Mottramlabs/RGB-LED-Coaster-Using-a-PIC/PCB Layout/RGB Coaster With PIC.pdf

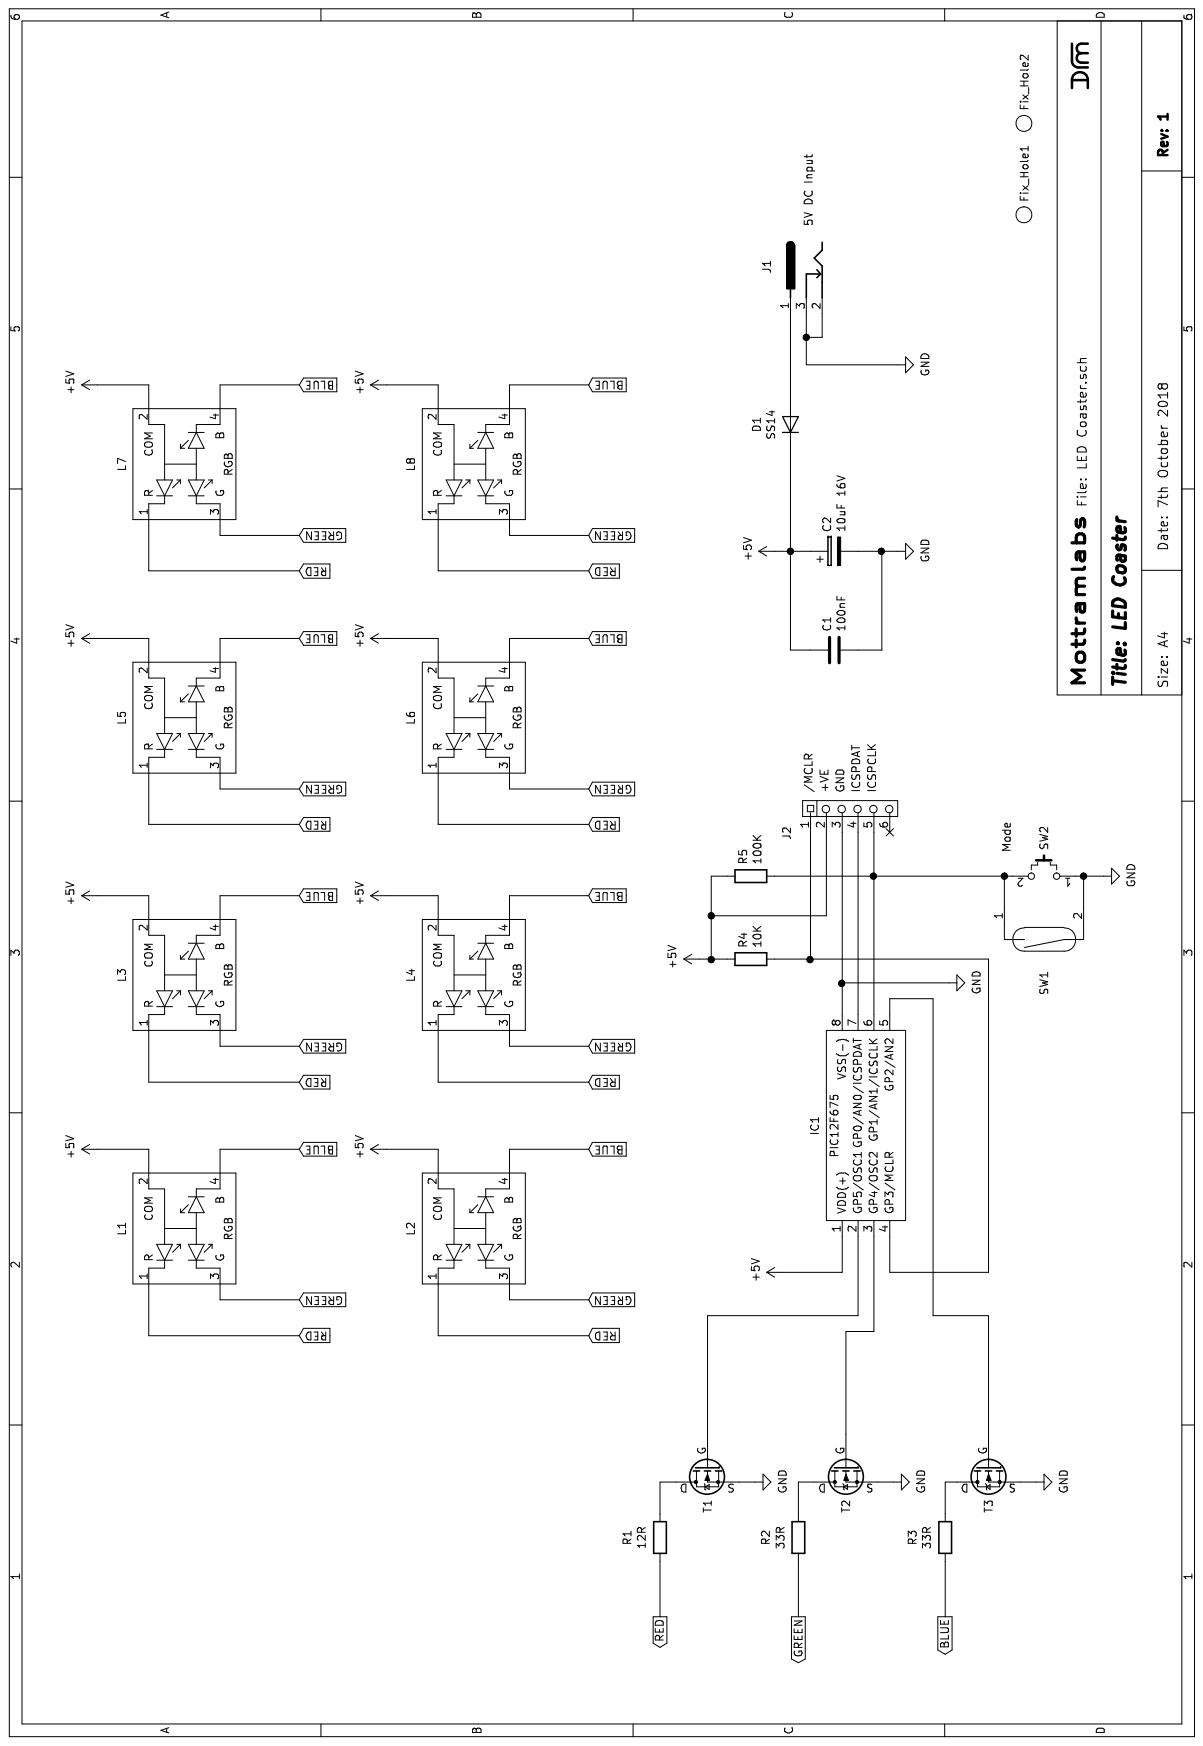
[picture p3: page 1]
